my-fi-25073/frog8k_ergodox/README.md

# frog8k_ergodox
Frog 8K ergodox keyboard pcb &amp; qmk firmware
