my-fi-25073/frog8k_ergodox/frog_8k_ergodox_model/cover.stl

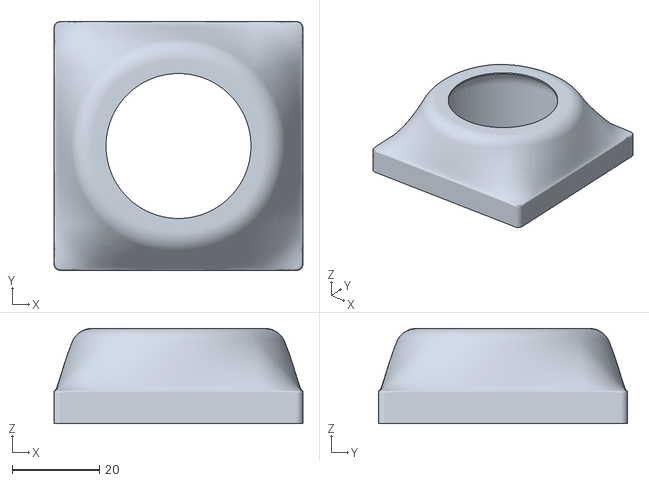
[picture p1: CAD file, 2025-03-24]
frog_8k_ergodox_model/cover.stl
57.1 x 57.1 x 21.9
