my-fi-25073/frog8k_ergodox/frog_8k_ergodox_pcb/frog_8k_ergodox_pcb.kicad_pcb

## KiCad design frog_8k_ergodox_pcb/frog_8k_ergodox_pcb.kicad_pcb (2025-04-13)

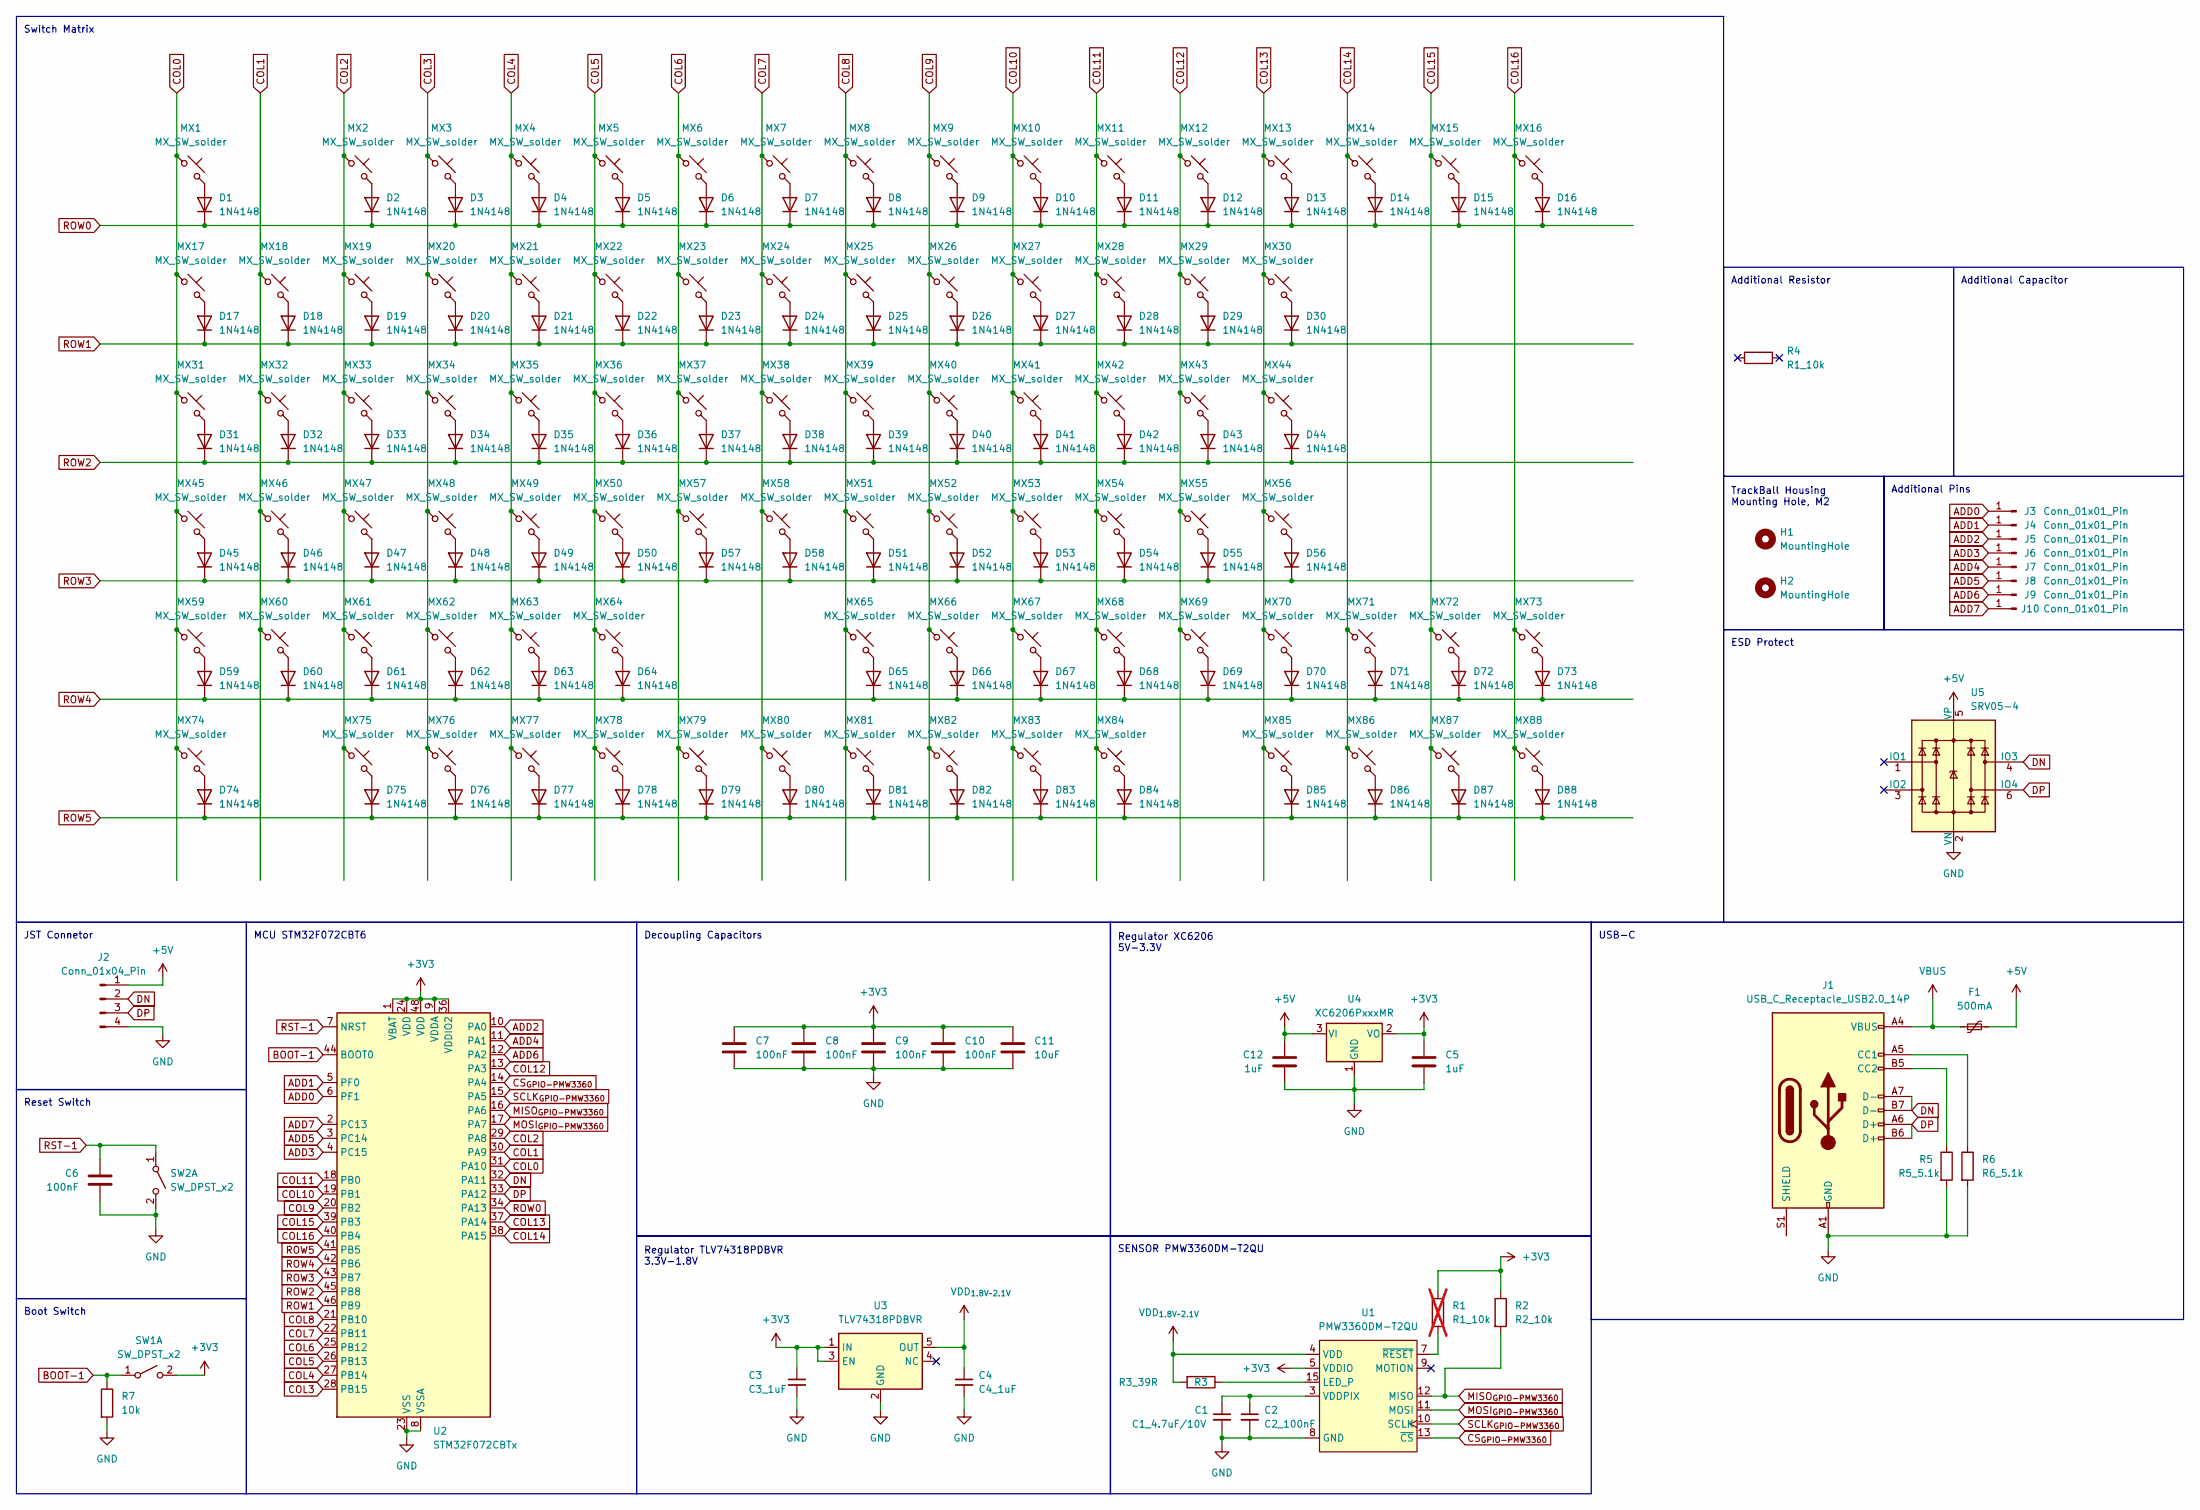
[picture p2: schematic frog_8k_ergodox_pcb.kicad_sch, Frog 8K Ergodox Track Ball PCB]

Parts:
C1: C1_4.7uF/10V; C_0805_2012Metric_Pad1.18x1.45mm_HandSolder
C2: C2_100nF; C_0805_2012Metric_Pad1.18x1.45mm_HandSolder
C3: C3_1uF; C_0805_2012Metric_Pad1.18x1.45mm_HandSolder
C4: C4_1uF; C_0805_2012Metric_Pad1.18x1.45mm_HandSolder
C5, C12: 1uF; C_0402_1005Metric
C6, C7, C8, C9, C10: 100nF; C_0402_1005Metric
C11: 10uF; C_0402_1005Metric
D1, D2, D3, D4, D5, D6, D7, D8, D9, D10, D11, D12, D13, D14, D15, D16, D17, D18, D19, D20, D21, D22, D23, D24, D25, D26, D27, D28, D29, D30, D31, D32, D33, D34, D35, D36, D37, D38, D39, D40, D41, D42, D43, D44, D45, D46, D47, D48, D49, D50, D51, D52, D53, D54, D55, D56, D57, D58, D59, D60, D61, D62, D63, D64, D65, D66, D67, D68, D69, D70, D71, D72, D73, D74, D75, D76, D77, D78, D79, D80, D81, D82, D83, D84, D85, D86, D87, D88: 1N4148; D_SOD-123
F1: 500mA; Fuse_1206_3216Metric; LCSC C70076
H1: MountingHole; MountingHole_2.2mm_M2_ISO14580_Pad
H2: MountingHole; MountingHole_2.2mm_M2_ISO7380_Pad
J1: USB_C_Receptacle_USB2.0_14P; USB_C_Receptacle_HRO_TYPE-C-31-M-12
J2: Conn_01x04_Pin; JST_SH_SM04B-SRSS-TB_1x04-1MP_P1.00mm_Horizontal
J3, J4, J5, J6, J7, J8, J9, J10: Conn_01x01_Pin; TestPoint_Pad_1.5x1.5mm
MX1, MX2, MX3, MX4, MX5, MX6, MX7, MX8, MX9, MX10, MX11, MX12, MX13, MX14, MX15, MX16, MX17, MX18, MX19, MX20, MX21, MX22, MX23, MX24, MX25, MX26, MX27, MX28, MX29, MX30, MX31, MX32, MX33, MX34, MX35, MX36, MX37, MX38, MX39, MX40, MX41, MX42, MX43, MX44, MX45, MX46, MX47, MX48, MX49, MX50, MX51, MX52, MX53, MX54, MX55, MX56, MX57, MX58, MX59, MX60, MX61, MX62, MX63, MX64, MX65, MX66, MX67, MX68, MX69, MX70, MX71, MX72, MX73, MX74, MX75, MX76, MX77, MX78, MX79, MX80, MX81, MX82, MX83, MX84, MX85, MX86, MX87, MX88: MX_SW_solder; SW_MX_1u
R1: R1_10k; R_0805_2012Metric_Pad1.20x1.40mm_HandSolder; not fitted
R2: R2_10k; R_0805_2012Metric_Pad1.20x1.40mm_HandSolder
R3: R3_39R; R_0805_2012Metric_Pad1.20x1.40mm_HandSolder
R4: R1_10k; R_0805_2012Metric_Pad1.20x1.40mm_HandSolder
R5: R5_5.1k; R_0805_2012Metric_Pad1.20x1.40mm_HandSolder
R6: R6_5.1k; R_0805_2012Metric_Pad1.20x1.40mm_HandSolder
R7: 10k; R_0402_1005Metric
SW1, SW2: SW_DPST_x2; SW_Push_1P1T_XKB_TS-1187A
U1: PMW3360DM-T2QU; PMW3360DM-T2QU 16Pin
U2: STM32F072CBTx; LQFP-48_7x7mm_P0.5mm
U3: TLV74318PDBVR; SOT-23-5
U4: XC6206PxxxMR; SOT-23-3
U5: SRV05-4; SOT-23-6

Connections:
+3V3: C3.1, C5.1, C7.1, C8.1, C9.1, C10.1, C11.1, R1.1, R2.1, SW1.2 (B), U1.5 (VDDIO), U2.1 (VBAT), U2.9 (VDDA), U2.24 (VDD), U2.36 (VDDIO2), U2.48 (VDD), U3.1 (IN), U3.3 (EN), U4.2 (VO)
+5V: C12.1, F1.2, J2.1, U4.3 (VI), U5.5 (VP)
ADD0: J3.1, U2.6 (PF1)
ADD1: J4.1, U2.5 (PF0)
ADD2: J5.1, U2.10 (PA0)
ADD3: J6.1, U2.4 (PC15)
ADD4: J7.1, U2.11 (PA1)
ADD5: J8.1, U2.3 (PC14)
ADD6: J9.1, U2.12 (PA2)
ADD7: J10.1, U2.2 (PC13)
BOOT-1: R7.1, SW1.1 (A), U2.44 (BOOT0)
COL0: MX1.1, MX17.1, MX31.1, MX45.1, MX59.1, MX74.1, U2.31 (PA10)
COL1: MX18.1, MX32.1, MX46.1, MX60.1, U2.30 (PA9)
COL2: MX2.1, MX19.1, MX33.1, MX47.1, MX61.1, MX75.1, U2.29 (PA8)
COL3: MX3.1, MX20.1, MX34.1, MX48.1, MX62.1, MX76.1, U2.28 (PB15)
COL4: MX4.1, MX21.1, MX35.1, MX49.1, MX63.1, MX77.1, U2.27 (PB14)
COL5: MX5.1, MX22.1, MX36.1, MX50.1, MX64.1, MX78.1, U2.26 (PB13)
COL6: MX6.1, MX23.1, MX37.1, MX57.1, MX79.1, U2.25 (PB12)
COL7: MX7.1, MX24.1, MX38.1, MX58.1, MX80.1, U2.22 (PB11)
COL8: MX8.1, MX25.1, MX39.1, MX51.1, MX65.1, MX81.1, U2.21 (PB10)
COL9: MX9.1, MX26.1, MX40.1, MX52.1, MX66.1, MX82.1, U2.20 (PB2)
COL10: MX10.1, MX27.1, MX41.1, MX53.1, MX67.1, MX83.1, U2.19 (PB1)
COL11: MX11.1, MX28.1, MX42.1, MX54.1, MX68.1, MX84.1, U2.18 (PB0)
COL12: MX12.1, MX29.1, MX43.1, MX55.1, MX69.1, U2.13 (PA3)
COL13: MX13.1, MX30.1, MX44.1, MX56.1, MX70.1, MX85.1, U2.37 (PA14)
COL14: MX14.1, MX71.1, MX86.1, U2.38 (PA15)
COL15: MX15.1, MX72.1, MX87.1, U2.39 (PB3)
COL16: MX16.1, MX73.1, MX88.1, U2.40 (PB4)
CS_{GPIO-PMW3360}: U1.13 (~CS), U2.14 (PA4)
DN: J1.A7 (D-), J1.B7 (D-), J2.2, U2.32 (PA11), U5.4 (IO3)
DP: J1.A6 (D+), J1.B6 (D+), J2.3, U2.33 (PA12), U5.6 (IO4)
GND: C1.2, C2.2, C3.2, C4.2, C5.2, C6.2, C7.2, C8.2, C9.2, C10.2, C11.2, C12.2, J1.A1 (GND), J1.A12 (GND), J1.B1 (GND), J1.B12 (GND), J2.4, R5.2, R6.2, R7.2, SW2.2 (B), U1.8 (GND), U2.8 (VSSA), U2.23 (VSS), U2.35 (VSS), U2.47 (VSS), U3.2 (GND), U4.1 (GND), U5.2 (VN)
MISO_{GPIO-PMW3360}: R2.2, U1.12 (MISO), U2.16 (PA6)
MOSI_{GPIO-PMW3360}: U1.11 (MOSI), U2.17 (PA7)
unnamed: D1.2 (A), MX1.2
unnamed: D2.2 (A), MX2.2
unnamed: D3.2 (A), MX3.2
unnamed: D4.2 (A), MX4.2
unnamed: D5.2 (A), MX5.2
unnamed: D6.2 (A), MX6.2
unnamed: D7.2 (A), MX7.2
unnamed: D8.2 (A), MX8.2
unnamed: D9.2 (A), MX9.2
unnamed: D10.2 (A), MX10.2
unnamed: D11.2 (A), MX11.2
unnamed: D12.2 (A), MX12.2
unnamed: D13.2 (A), MX13.2
unnamed: D14.2 (A), MX14.2
unnamed: D15.2 (A), MX15.2
unnamed: D16.2 (A), MX16.2
unnamed: D17.2 (A), MX17.2
unnamed: D18.2 (A), MX18.2
unnamed: D19.2 (A), MX19.2
unnamed: D20.2 (A), MX20.2
unnamed: D21.2 (A), MX21.2
unnamed: D22.2 (A), MX22.2
unnamed: D23.2 (A), MX23.2
unnamed: D24.2 (A), MX24.2
unnamed: D25.2 (A), MX25.2
unnamed: D26.2 (A), MX26.2
unnamed: D27.2 (A), MX27.2
unnamed: D28.2 (A), MX28.2
unnamed: D29.2 (A), MX29.2
unnamed: D30.2 (A), MX30.2
unnamed: D31.2 (A), MX31.2
unnamed: D32.2 (A), MX32.2
unnamed: D33.2 (A), MX33.2
unnamed: D34.2 (A), MX34.2
unnamed: D35.2 (A), MX35.2
unnamed: D36.2 (A), MX36.2
unnamed: D37.2 (A), MX37.2
unnamed: D38.2 (A), MX38.2
unnamed: D39.2 (A), MX39.2
unnamed: D40.2 (A), MX40.2
unnamed: D41.2 (A), MX41.2
unnamed: D42.2 (A), MX42.2
unnamed: D43.2 (A), MX43.2
unnamed: D44.2 (A), MX44.2
unnamed: D45.2 (A), MX45.2
unnamed: D46.2 (A), MX46.2
unnamed: D47.2 (A), MX47.2
unnamed: D48.2 (A), MX48.2
unnamed: D49.2 (A), MX49.2
unnamed: D50.2 (A), MX50.2
unnamed: D51.2 (A), MX51.2
unnamed: D52.2 (A), MX52.2
unnamed: D53.2 (A), MX53.2
unnamed: D54.2 (A), MX54.2
unnamed: D55.2 (A), MX55.2
unnamed: D56.2 (A), MX56.2
unnamed: D57.2 (A), MX57.2
unnamed: D58.2 (A), MX58.2
unnamed: D59.2 (A), MX59.2
unnamed: D60.2 (A), MX60.2
unnamed: D61.2 (A), MX61.2
unnamed: D62.2 (A), MX62.2
unnamed: D63.2 (A), MX63.2
unnamed: D64.2 (A), MX64.2
unnamed: D65.2 (A), MX65.2
unnamed: D66.2 (A), MX66.2
unnamed: D67.2 (A), MX67.2
unnamed: D68.2 (A), MX68.2
unnamed: D69.2 (A), MX69.2
unnamed: D70.2 (A), MX70.2
unnamed: D71.2 (A), MX71.2
unnamed: D72.2 (A), MX72.2
unnamed: D73.2 (A), MX73.2
unnamed: D74.2 (A), MX74.2
unnamed: D75.2 (A), MX75.2
unnamed: D76.2 (A), MX76.2
unnamed: D77.2 (A), MX77.2
unnamed: D78.2 (A), MX78.2
unnamed: D79.2 (A), MX79.2
unnamed: D80.2 (A), MX80.2
unnamed: D81.2 (A), MX81.2
unnamed: D82.2 (A), MX82.2
unnamed: D83.2 (A), MX83.2
unnamed: D84.2 (A), MX84.2
unnamed: D85.2 (A), MX85.2
unnamed: D86.2 (A), MX86.2
unnamed: D87.2 (A), MX87.2
unnamed: D88.2 (A), MX88.2
unnamed: J1.A5 (CC1), R6.1
unnamed: J1.B5 (CC2), R5.1
unnamed: R3.1, U1.15 (LED_P)
unnamed: C1.1, C2.1, U1.3 (VDDPIX)
unnamed: R1.2, U1.7 (~RESET)
ROW0: D1.1 (K), D2.1 (K), D3.1 (K), D4.1 (K), D5.1 (K), D6.1 (K), D7.1 (K), D8.1 (K), D9.1 (K), D10.1 (K), D11.1 (K), D12.1 (K), D13.1 (K), D14.1 (K), D15.1 (K), D16.1 (K), U2.34 (PA13)
ROW1: D17.1 (K), D18.1 (K), D19.1 (K), D20.1 (K), D21.1 (K), D22.1 (K), D23.1 (K), D24.1 (K), D25.1 (K), D26.1 (K), D27.1 (K), D28.1 (K), D29.1 (K), D30.1 (K), U2.46 (PB9)
ROW2: D31.1 (K), D32.1 (K), D33.1 (K), D34.1 (K), D35.1 (K), D36.1 (K), D37.1 (K), D38.1 (K), D39.1 (K), D40.1 (K), D41.1 (K), D42.1 (K), D43.1 (K), D44.1 (K), U2.45 (PB8)
ROW3: D45.1 (K), D46.1 (K), D47.1 (K), D48.1 (K), D49.1 (K), D50.1 (K), D51.1 (K), D52.1 (K), D53.1 (K), D54.1 (K), D55.1 (K), D56.1 (K), D57.1 (K), D58.1 (K), U2.43 (PB7)
ROW4: D59.1 (K), D60.1 (K), D61.1 (K), D62.1 (K), D63.1 (K), D64.1 (K), D65.1 (K), D66.1 (K), D67.1 (K), D68.1 (K), D69.1 (K), D70.1 (K), D71.1 (K), D72.1 (K), D73.1 (K), U2.42 (PB6)
ROW5: D74.1 (K), D75.1 (K), D76.1 (K), D77.1 (K), D78.1 (K), D79.1 (K), D80.1 (K), D81.1 (K), D82.1 (K), D83.1 (K), D84.1 (K), D85.1 (K), D86.1 (K), D87.1 (K), D88.1 (K), U2.41 (PB5)
RST-1: C6.1, SW2.1 (A), U2.7 (NRST)
SCLK_{GPIO-PMW3360}: U1.10 (SCLK), U2.15 (PA5)
VBUS: F1.1, J1.A4 (VBUS), J1.A9 (VBUS), J1.B4 (VBUS), J1.B9 (VBUS)
VDD_{1.8V~2.1V}: C4.1, R3.2, U1.4 (VDD), U3.5 (OUT)

Notes on the sheet:
TrackBall Housing Mounting Hole, M2
Regulator XC6206 5V-3.3V
Additional Pins
USB-C
SENSOR PMW3360DM-T2QU
Switch Matrix
Regulator TLV74318PDBVR 3.3V-1.8V
Decoupling Capacitors
Additional Resistor
MCU STM32F072CBT6
JST Connetor
Reset Switch
ESD Protect
Additional Capacitor
Boot Switch

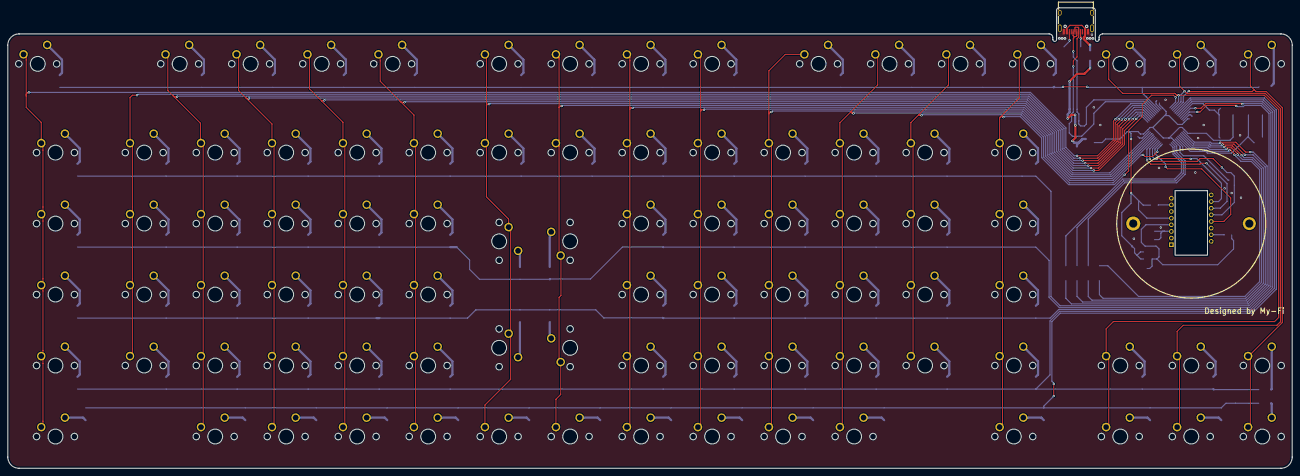
[picture p3: board frog_8k_ergodox_pcb.kicad_pcb from above]

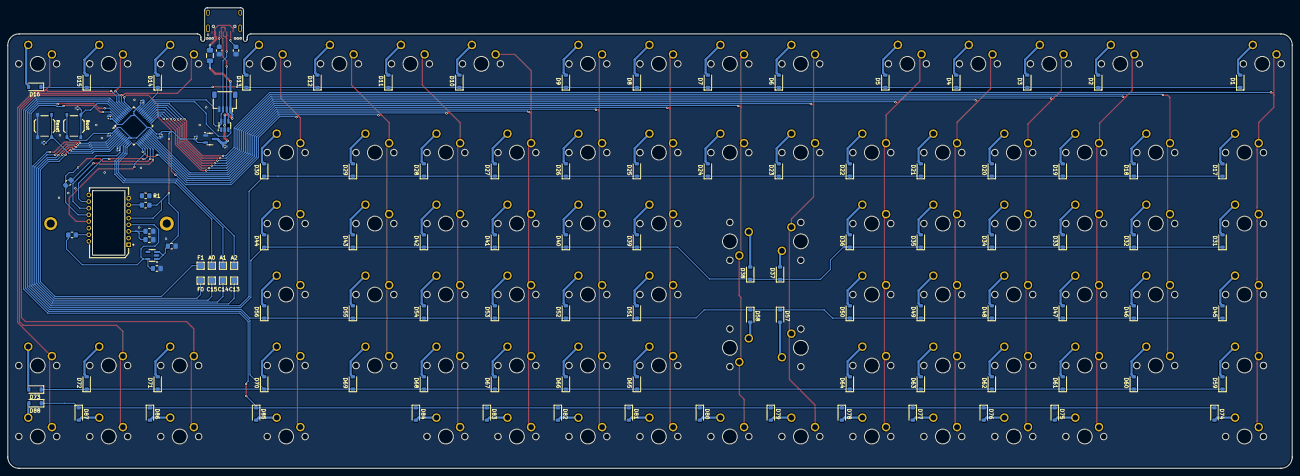
[picture p4: board frog_8k_ergodox_pcb.kicad_pcb from below]

Board: 2 copper layers, 344.7 x 123.6 mm, 217 parts (124 on the bottom side), 137 nets.

Other parts of the board:
mouse-bite-custom: VAL**; mouse-bite-custom
mouse-bite-custom#2: VAL**; mouse-bite-custom
