my-fi-25073/frog8k_ergodox/(commit log)

2025-03-02 Added Default pcb project files
    [frog_8k_ergodox_pcb.kicad_pcb, frog_8k_ergodox_pcb.kicad_sch]
2025-03-03 Updated Symbols
    [frog_8k_ergodox_pcb.kicad_sch]
2025-03-04 Added 3v3 power and gnd symbol
    [frog_8k_ergodox_pcb.kicad_sch]
2025-03-05 Updated Capcitors and circuits for PMW3360
    [frog_8k_ergodox_pcb.kicad_sch]
2025-03-06 Connected pmw3360 to stm32
    [frog_8k_ergodox_pcb.kicad_sch]
2025-03-12 Updated PMW3360's GPIO Pin.
    [frog_8k_ergodox_pcb.kicad_sch]
2025-03-13 Removed unused symbol in PMW3360, Added Regulator for PCB
    [frog_8k_ergodox_pcb.kicad_sch]
2025-03-24 Added Trackball Cover STL model made by HYT
    [cover.stl]
2025-03-24 Added Switches and JST connector.
    [frog_8k_ergodox_pcb.kicad_sch]
2025-03-26 Updated Matrix & Col2Row Based Diodes.
    [frog_8k_ergodox_pcb.kicad_sch]
2025-03-27 Added Pull Up Resistor Symbol on PMW3360 NRESET Pin, Added ESD Protection.
    [frog_8k_ergodox_pcb.kicad_sch]
2025-03-30 Added fuse to vbus.
    [frog_8k_ergodox_pcb.kicad_sch]
2025-04-03 Added Keyboard Layout on PCB design
    [frog_8k_ergodox_pcb.kicad_pcb, frog_8k_ergodox_pcb.kicad_sch]
2025-04-03 Rotated middle keys.
    [frog_8k_ergodox_pcb.kicad_pcb]
2025-04-04 Updated USB-C Position, Added PCB Edge Cut
    [frog_8k_ergodox_pcb.kicad_pcb]
2025-04-06 Updated TrackBall Housing Position & Mounting Hole Position.
    [frog_8k_ergodox_pcb.kicad_pcb]
2025-04-07 Fixed matirix, Reconnect U1 Symbol to Footprint, relocate diode position.
    [frog_8k_ergodox_pcb.kicad_pcb, frog_8k_ergodox_pcb.kicad_sch]
2025-04-07 Updated PCB design.
    [frog_8k_ergodox_pcb.kicad_pcb, frog_8k_ergodox_pcb.kicad_sch]
2025-04-08 Fixed USB Port 5V to 3.3V, Added Matrix Row/Col
    [frog_8k_ergodox_pcb.kicad_pcb, frog_8k_ergodox_pcb.kicad_sch]
2025-04-09 Added plate file, Updated Matrix route, Additional Pin routes
    [frog_8k_ergodox_pcb.kicad_pcb, frog_8k_ergodox_pcb.kicad_sch]
2025-04-09 updated footprints...
    [frog_8k_ergodox_pcb.kicad_pcb, frog_8k_ergodox_pcb.kicad_sch]
2025-04-10 Connect PMW3360 pins.
    [frog_8k_ergodox_pcb.kicad_pcb, frog_8k_ergodox_pcb.kicad_sch]
2025-04-11 Connected All nets.
    [frog_8k_ergodox_pcb.kicad_pcb, frog_8k_ergodox_pcb.kicad_sch]
2025-04-11 fixed connection little bit
    [frog_8k_ergodox_pcb.kicad_pcb]
2025-04-12 Connect and fill ground.
    [frog_8k_ergodox_pcb.kicad_pcb]
2025-04-12 Almost Done with pcb
    [frog_8k_ergodox_pcb.kicad_pcb, frog_8k_ergodox_pcb.kicad_sch]
2025-04-13 Released V1.0.00
    [frog_8k_ergodox_pcb.kicad_pcb]
